SmithVent2020/circuit-control/images/enclosure_top.jpg

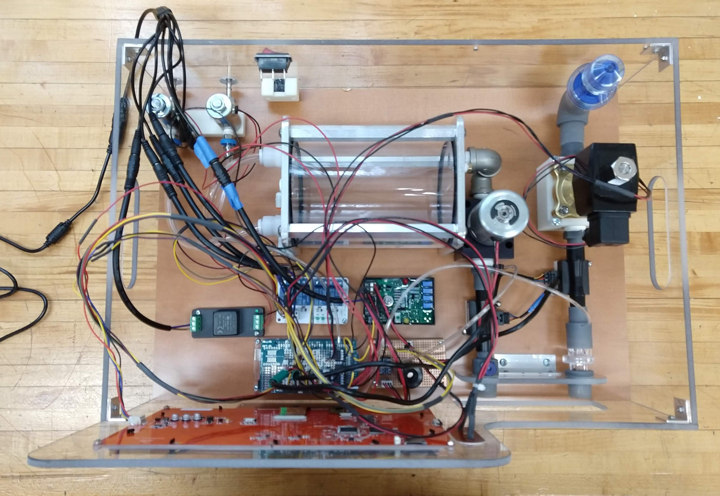
images/enclosure_top.jpg
