SmithVent2020/circuit-control/TestAlarmManager/README.txt

TestAlarmManager requires AlarmManager.cpp and AlarmManager.h in the same folder to function properly.
