SmithVent2020/circuit-control/AlarmManager.cpp

#include "AlarmManager.h"
#include "Display.h"

static const alarmCode firstCodeAtPriority[] = {
  FIRST_ALARM,                              // First HIGH_PRIORITY code
  alarmCode(ALARM_MAX_HIGH_PRIORITY + 1),   // First MED_PRIORITY code
  alarmCode(ALARM_MAX_MED_PRIORITY + 1),    // First LOW_PRIORITY code
  N_ALARMS                                  // First non-alarm
};

// Return whether the passed alarm code is valid.
// In most cases, an invalid code results in no action, but it theoretically
// should be logged as a logic error.
static inline bool isValidCode(alarmCode code) {
  return FIRST_ALARM <= code && code < N_ALARMS;
}

/*
 *  Initializes with all alarms off
 */
AlarmManager::AlarmManager() {
  for (alarmCode i = FIRST_ALARM; i < N_ALARMS; ++i) {
    alarms[i] = false;
  }
  alarmSounding = alarmLED = false;
  alarmPhase = alarmPhaseLED = alarmNextTone = alarmNextBlink = 0;
}

/*
 *  Returns the priority associated with the given alarm code
 *
 *  @param code:  alarm we want the priority of
 *  @returns: the alarms priority (high, medium, low)
 */
alarmPriority AlarmManager::getAlarmPriority(alarmCode code) {
  if (code <= ALARM_MAX_HIGH_PRIORITY) {
    return HIGH_PRIORITY;
  } else if (code <= ALARM_MAX_MED_PRIORITY) {
    return MED_PRIORITY;
  } else if (code <= ALARM_MAX_LOW_PRIORITY) {
    return LOW_PRIORITY;
  } else {
    return NO_ALARM;
  }
}

/*
 * Returns code (index) of highest priority alarm currently active
 * or ALARM_NONE if no alarm is currently set
 */
alarmCode AlarmManager::topAlarm() {
  alarmCode result = ALARM_NONE;
  for (alarmCode i = FIRST_ALARM; i < N_ALARMS; ++i) {
    if (alarms[i] == true) {
      result = i;
      break;
    }
  }
  return result;
}

/*
 * Returns true if any alarm are set at given level, false otherwise
 */
bool AlarmManager::onPriority(alarmPriority level) {
  alarmCode first = firstCodeAtPriority[level];
  alarmCode past  = firstCodeAtPriority[level + 1];
  for (alarmCode i = first; i < past; ++i) {
    if (alarms[i]) {
      return true;
    }
  }
  return false;
}

/*
 * Makes specified alarm active
 *
 * Sets alarm status to true and unsilences alarm.
 * Does nothing if alarm is already set
 *
 * No effect if invalid code is supplied
 *
 * @params code -- alarm index
 */
void AlarmManager::activateAlarm(alarmCode code) {
  if (isValidCode(code)&&!alarms[code]) {
    alarms[code] = true;
    alarmCode top = topAlarm();
    alarmLED = true;
    if (top == code) {
      // Turning on a higher-priority alarm unsilences
      // @TODO: Shouldn't turning on any alarm at same or higher priority unsilence alarms?
      alarmSounding = true;
      beginAlarm();
      display.showAlarm(alarmText[code],getAlarmPriority(code));
    }
  }
}

/*
 * Makes specified alarm inactive
 *
 * Sets the specified alarm status to false.
 * Checks for remaining alarms.  If higher priority, no further action required.
 * If lower priority alarm remains active, sets onset timestamp & next tone.
 * If no alarms remain active, sets alarmSounding and alarmLED to false.
 *
 * No effect if alarm is already off or invalid code is supplied
 *
 * @params code -- alarm index
 */
void AlarmManager::deactivateAlarm(alarmCode code) {
  if (alarmStatus(code) == true) {
    alarms[code] = false;
    quellAlarm(code);  // cease LED display and tone for deactivated alarm
    display.stopAlarm();
    alarmCode top = topAlarm();  // check for new top alarm
    if (top == ALARM_NONE) {
      // no alarms remain
      alarmSounding = alarmLED = false;
      alarmRearm = ULONG_MAX;
    } else if (top > code) {   // recall that lowest code is highest priority!
      // lower priority alarm remains
      display.showAlarm(alarmText[top],getAlarmPriority(top));
      beginAlarm();
    }  // else allow higher-priority alarm to continue
  }
}

/*
 * Returns status of specified alarm (true if on)
 * Always returns false for invalid code
 *
 * @params code -- alarm index
 */
bool AlarmManager::alarmStatus(alarmCode code) {
  return isValidCode(code) && alarms[code];
}

/*
 * Silences all current alarms for specified duration.
 * New alarm will override silence if they are higher priority than
 * any current.
 */
void AlarmManager::silence(unsigned int durationMs) {
  alarmSounding = false;
  noTone(BUZZER);  // stop auditory alarm but leave LED on
  alarmRearm = millis() + durationMs;
}

/*
 * Checks whether there is a currently active alarm that is silent
 */
bool AlarmManager::isSilenced() {
  // note that this will return TRUE for a low-priority alarm after the initial tone
  // not sure this is the desired behavior...
  return (! alarmSounding && topAlarm() != ALARM_NONE);
}

/*
 * Resets the alarm production variables
 */
void AlarmManager::beginAlarm() {
  alarmSounding = alarmLED = true;
  alarmNextTone = alarmNextBlink = millis();  // reset for new alarm
  alarmPhase = alarmPhaseLED = 0;
  alarmRearm = ULONG_MAX;
}

/*
 * Cease LED display and tone for this alarm.
 * No effect on alarm status.
 *
 * @params code -- alarm index
 */
void AlarmManager::quellAlarm(alarmCode code) {
  // stop sound
  noTone(BUZZER);

  // stop LED
  switch (getAlarmPriority(code)) {
    case HIGH_PRIORITY:
      digitalWrite(RED_LED, LOW);
      break;
    case MED_PRIORITY:
      digitalWrite(YELLOW_LED, LOW);
      break;
    case LOW_PRIORITY:
      digitalWrite(YELLOW_LED, LOW);
      break;
  }
}

/**
 * Checks whether a specified time has elapsed.
 *
 * Assumes a very large difference between time and target
 * is result of rollover of millis()
 *
 * @param t -- current time
 * @param targetTime --  target time
 */
bool AlarmManager::timeIsNow(unsigned long t, unsigned long targetTime) {
  return t >= targetTime && t - targetTime < (ULONG_MAX >> 1);
}

/**
 * Updates alarm LED/buzzer status as necessary based on current top alarm and phase
 *
 * Each priority level has a hard-coded pattern of sound & LED display
 * Additional patterns may be added as necessary
 * Could make this more general and express the display patterns as data
 * but this seems good enough for a small number of possibilities
 */
void AlarmManager::maintainAlarms() {
  unsigned long t = millis();

  // first check if there are silenced alarms that need to be reactivated
  if (timeIsNow(t,alarmRearm)) {
    beginAlarm();
  }

  if (alarmSounding) {
    alarmCode top = topAlarm();
    if (top != ALARM_NONE) {
      // audible alarms (current highest only):
      if (timeIsNow(t,alarmNextTone)) {
        // @TODO These alarms would be better expressed as a table and state machine
        switch (getAlarmPriority(top)) {
          case HIGH_PRIORITY:
            // pattern is beep beep beep rest beep beep rest rest rest rest x2
            // each beat is 125 ms; beeps last for 75 ms at 880 Hz (A5)
            // ten beep pattern is followed by 6000 ms interval
            switch (alarmPhase) {
              case 0:
              case 1:
              case 3:
              case 5:
              case 6:
              case 8:
                tone(BUZZER,880,75);
                alarmPhase += 1;
                alarmNextTone = t+125;
                break;
              case 2:
              case 7:
                tone(BUZZER,880,75);
                alarmPhase += 1;
                alarmNextTone = t+250;
                break;
              case 4:
                tone(BUZZER,880,75);
                alarmPhase += 1;
                alarmNextTone = t+625;
                break;
              case 9:
                tone(BUZZER,880,75);
                alarmPhase = 0;
                alarmNextTone = t+6125;
                break;
            }
            break;
          case MED_PRIORITY:
            // three beeps followed by 12000 ms of silence
            // each segment is 250 ms; beeps last for 150 ms at 660 Hz (E5)
            if (alarmPhase == 0) {
              tone(BUZZER,660,150);
              alarmPhase = 1;
              alarmNextTone = t+250;
            } else if (alarmPhase == 1) {
              tone(BUZZER,660,150);
              alarmPhase = 2;
              alarmNextTone = t+250;
            } else {
              tone(BUZZER,660,150);
              alarmPhase = 0;
              alarmNextTone = t+12250;
            }
            break;
          case LOW_PRIORITY:
            // one 2000 ms tone, not repeated
            tone(BUZZER,440,2000);  // D3
            alarmNextTone = ULONG_MAX;
            alarmSounding = false;
            break;
        }
      }
    } else {
      // no alarm detected -- reaching this point is probably a bug
      // because alarmSounding should only be true when there is an alarm set
      Serial.println("ERROR:  alarmSounding set but no alarm active.");
      alarmSounding = false;
    }
    if (alarmLED == true) {
      // visible alarms (both LED can blink if appropriate)
      if (timeIsNow(t,alarmNextBlink)) {
        // high priority blinks red LED at 2 Hz
        if (onPriority(HIGH_PRIORITY)) {
          digitalWrite(RED_LED, 1-alarmPhaseLED%2);
        } else {
          digitalWrite(RED_LED, LOW);
        }
        // medium priority blinks yellow LED at 0.8 Hz
        if (onPriority(MED_PRIORITY)) {
          digitalWrite(YELLOW_LED, 1-alarmPhaseLED/5);
        } else if (onPriority(LOW_PRIORITY)) {
          // low priority leaves yellow LED on solid
          digitalWrite(YELLOW_LED, HIGH);
        } else {
          digitalWrite(YELLOW_LED, LOW);
        }
        alarmPhaseLED = (alarmPhaseLED+1)%10;
        alarmNextBlink = t+250;
      }
    } else {
      // no alarm detected -- reaching this point is probably a bug
      // because alarmLED should only be true when there is an alarm set
      Serial.println("ERROR:  alarmLED set but no alarm active.");
      alarmLED = false;
    }
  }
}

AlarmManager alarmMgr;
