SmithVent2020/circuit-control/(commit log)

2020-05-07 Update circuit-control.ino
    I added a comment. This is just to make sure I know how Github works :)
2020-05-08 Added solenoid valve actuation
2020-05-08 Added valve status function
2020-05-08 Added Valve_Status function
2020-05-08 Update Valve status function
2020-05-08 Functions for turning alarm (buzzer + LED) on and off
2020-05-18 Add PID library
2020-05-27 Fix small issues from code review
    [Flow.cpp, Oxygen.cpp, Pressure.cpp, circuit-control.ino]
2020-05-27 Corrected comment on now() function
    [circuit-control.ino]
2020-05-27 Update state machine. Convert all time unites to integral milliseconds
2020-05-29 Alarm updates (#14)
    * Changed beep/LED patterns to comply with UI guidelines
    * Extended tests
    * Cleaned up alarm code, made changes requested by UI
    * Added ALARM_SHUTDOWN alarm.
    * Moved ALARM_TIDAL_HIGH to medium priority.
    * Removed extra priority array, replaced with getAlarmPriority function.
    Authored by: nhprof
    [AlarmManager.cpp, AlarmManager.h, TestAlarmManager.ino]
2020-05-30 Implement O2 management. Move definitions of sensors and valves into appropriate headers and .cpp files.
2020-06-01 Fix bugs and warnings in Oxygen sensor code (currently unused)
    [Oxygen.cpp, Oxygen.h]
2020-06-01 Fixed warnings and bugs in alarm manager
    [AlarmManager.cpp, AlarmManager.h, circuit-control.ino]
2020-06-01 Implemented flow-to-volume measurement. Detect when exp volume is 80% of insp voume.
2020-06-01 Fixes to insp-volume branch as per Naylani's review
    [circuit-control.ino]
2020-06-01 integrated Nick's burst code
    -changed the PID library by moving the initialize() function from private to public
    -added burst code to ProportionalValve files
    -updated beginBreath, maintainBreath() and endBreath() functions accordingly
2020-06-01 added readSensors function
    - added the readSensors function
    - added a printSensors function for testing and debugging,
    - added Serial.print statements at the beginning of each state again for testing and debugging purposes.
2020-06-01 got rid of processVCSettings
    - distributed the commands that were in processVCSettings to there correct places
    [circuit-control.ino]
2020-06-01 added readReservoir() function and added O2 management
    Since the reservoir is now using a different pressure sensor, it needed to be interpreted with a different function. I added a readReservoir() function to the Pressure.cpp file and made the necessary changes to Pressure.h and circuit-control.ino.
    - added the O2 management function to main loop to refill the reservoir
2020-06-01 added print statements to every state
2020-06-01 print state
2020-06-02 added a close exp valve command to insp
    becaus the exp valve is normally open
2020-06-02 added printing of accumulated volumes
2020-06-02 switched out SV4 controls
    replaced the expValve.open() with digitalWrite(SV4_CONTROL, LOW) and expValve.close() with digitalWrite(SV4_CONTROL, HIGH) to see if the close and open functions were working correctly
    [circuit-control.ino]
2020-06-02 fixed exp transition error
    -changed bpm to 15
    -now displaying flowrates in cc/ms
    - added beginExpiratoryCycle() to the if statement that transitions between insp and exp state in VC mode. Volume and exp timer was not being reset.
    [Flow.cpp, circuit-control.ino]
2020-06-02 for debugging, took out volume and pressure triggers
    now eeverything runs on a timer
2020-06-02 added debug comments to pressure.cpp
2020-06-02 added back volume triggers
    also added beginExpiratoryCycle when we switch to exp from insp
2020-06-02 set to OFF_STATE in setup
    made it so off state always just invokes the beginInspiration function and switches to the insp state
    Also added print statements for the exp timers
2020-06-02 Update O2management.cpp
    Bug fix on equality test & safety default
    [O2management.cpp]
2020-06-03 Fix speed and accuracy of Flow and Pressure sensor reading logic
    [Flow.cpp, Pressure.cpp]
2020-06-03 fixed timing errors and checked units
    - discovered and fixed a a few timer VS duration errors by checking every time-related variable
    - checked flow and pressure units on all flow and pressure-related variables
    [Constants.h, Pressure.cpp, ProportionalValve.cpp, circuit-control.ino]
2020-06-03 made prints easier to read and SV4 trigger change
    also commented out the digitalWrite and used .open and .close for SV4 opening and closing
2020-06-03 changed flow read() to accont for magnitude error
    added comments to prop valve control algorithms
    [Flow.cpp, ProportionalValve.cpp, circuit-control.ino]
2020-06-03 changed flow reader vars to signed long
2020-06-03 fixed set flow peak problem
    [Flow.cpp]
2020-06-03 printing R, the sensor analog reading
2020-06-03 more print statements
2020-06-03 Fix flow read function
    THere was one remaining unsigned long, which I removed. It seems to work now.
    [Flow.cpp]
2020-06-04 Valve state made operational
    Field state_ was never updated (or used). FIxed so we can track valve positions as program executes.
    [Valve.h]
2020-06-04 Updated ProportionalValve to maintain position_ field
    Now all valves can be queried for their status
2020-06-04 took out pressure patient trigger
2020-06-04 added print statements to flow.h open and close functions
2020-06-04 corrected to millis() in exp hold trigger
    [circuit-control.ino]
2020-06-04 commented out extra print statements
2020-06-04 added flow calebration function
2020-06-04 minor edits to flow calibration
2020-06-04 added print statements
2020-06-04 Fix Flow calibration default
    [Flow.cpp, Flow.h, circuit-control.ino]
2020-06-05 added prints
2020-06-05 added PID printing
2020-06-05 added valve print statements
2020-06-05 fixed local pid variable problem
    [ProportionalValve.cpp, circuit-control.ino]
2020-06-05 commented out most serial.print statements
2020-06-05 Changed baudrate to 115200 and fixed some defaults
    [Display.cpp]
2020-06-06 testing millis with waveform
2020-06-06 fixed pressure wave
2020-06-06 added flow, and pressure alarms for VC mode
2020-06-07 Revert "Bug fix: t->tt"
    This reverts commit 6ece0742cfeec8df6d349363d1a3e3ba0490eab3.
    [circuit-control.ino]
2020-06-07 Revert "Temporary timing code"
    This reverts commit 83a4c614f3a8d927ad7b7b8dd9a5119717bfd73c.
    [circuit-control.ino]
2020-06-07 fixed alarm but with !, added alarm print statements
    [circuit-control.ino]
2020-06-07 Activating a currently active alarm does nothing.
2020-06-07 printing TVi to serial port
2020-06-07 Vc twui flow cal (#25)
    * Revamped flow sensor calibration
    * Move flow calibration to after pin setup
    * Added some output to see what is happening
    * Added debug info
    * Adjusted flow calibration
    * Move calibration after SV4 close
2020-06-07 print pip statements
2020-06-08 added back pressure patient trigger
2020-06-08 changed sensitivity for patient trigger
2020-06-08 Added event listener for buttons
2020-06-08 put back pressure trigger
2020-06-08 took out pressure trigger
2020-06-08 update graph with flow out in expiration
2020-06-08 switch flow out reading to negative
2020-06-08 added pressure trigger back
2020-06-08 took out patient trigger
2020-06-08 added pplat print
2020-06-08 Reveal lower alarms when top is resolved
    [AlarmManager.cpp]
2020-06-10 fully commented circuit-control.ino
2020-06-11 Big fix in alarms, some cleanup
    [AlarmManager.cpp, AlarmManager.h, circuit-control.ino]
2020-10-06 Replaced missing PID files
    Not sure how they disappeared.
